nmailoa/ee149-proj/Presentation1.pptx

getCalibration

getAcceleration

getGyroscope

Serial.print(data)

## Slide 2

getCalibration

getAcceleration

getGyroscope

calibration?

Y

wait for button

populate cal.

Serial.write()

N

calibrated?

N

populate data

Y

reading > 4?

Y

N
