nmailoa/ee149-proj/final-report/figures/button.jpg

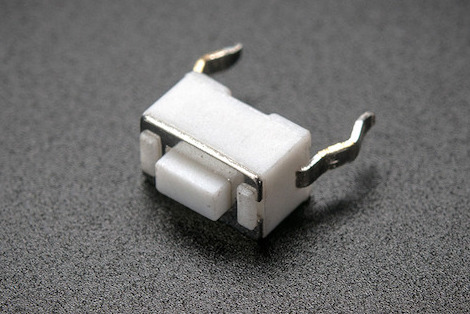
final-report/figures/button.jpg
