nmailoa/ee149-proj/final-report/figures/led.jpg

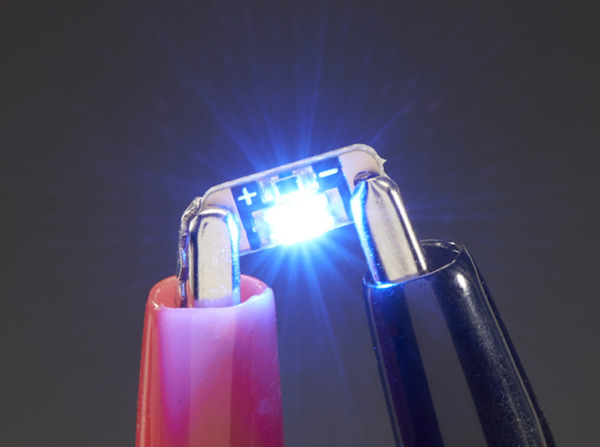
final-report/figures/led.jpg
