nmailoa/ee149-proj/full_body.png

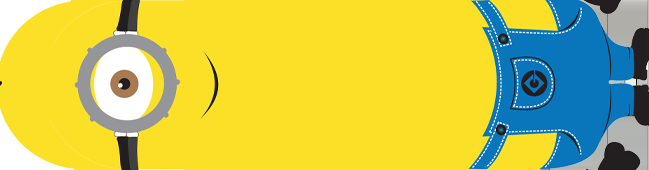
full_body.png
