nmailoa/ee149-proj/Screen Shot 2015-12-12 at 4.27.55 PM.png

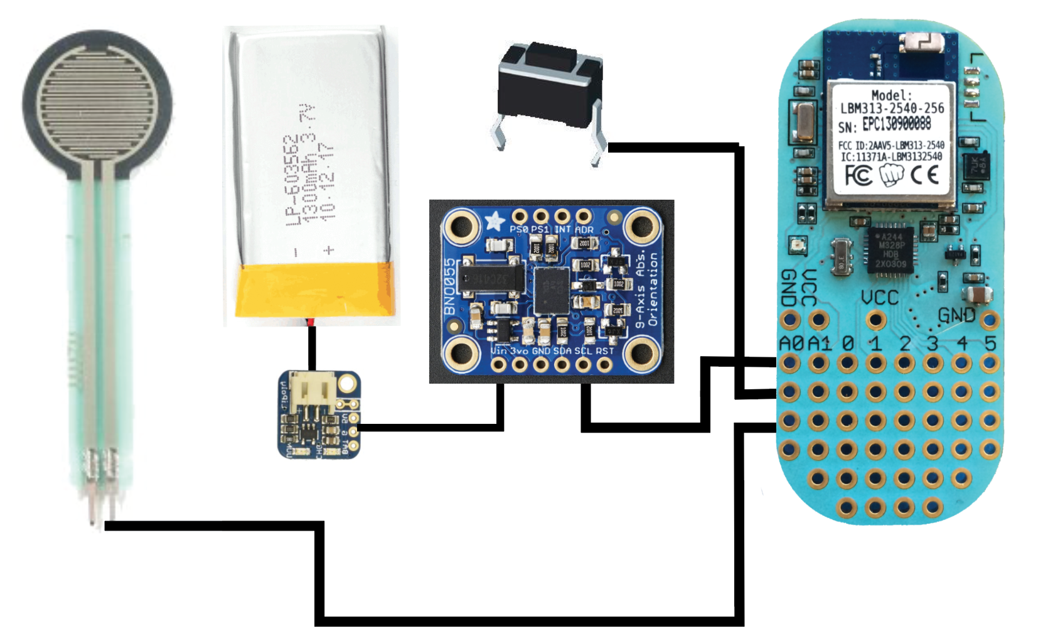
Screen Shot 2015-12-12 at 4.27.55 PM.png
