nmailoa/ee149-proj/arduino/speed/speed.ino

/* 
  This sketch reads the ambient temperature from the Bean's on-board temperature sensor. 
  
  The temperature readings are sent over serial and can be accessed in Arduino's Serial Monitor.
  
  To use the Serial Monitor, set Arduino's serial port to "/tmp/tty.LightBlue-Bean" 
  and the Bean as "Virtual Serial" in the OS X Bean Loader.
    
  This example code is in the public domain.
*/
char buf[100] = {0x30, 0x31, 0x32, 0x33, 0x34, 0x35, 0x36, 0x37, 0x38, 0x39,0x30, 0x31, 0x32, 0x33, 0x34, 0x35, 0x36, 0x37, 0x38, 0x39,0x30, 0x31, 0x32, 0x33, 0x34, 0x35, 0x36, 0x37, 0x38, 0x39,0x30, 0x31, 0x32, 0x33, 0x34, 0x35, 0x36, 0x37, 0x38, 0x39,0x30, 0x31, 0x32, 0x33, 0x34, 0x35, 0x36, 0x37, 0x38, 0x39,0x30, 0x31, 0x32, 0x33, 0x34, 0x35, 0x36, 0x37, 0x38, 0x39,0x30, 0x31, 0x32, 0x33, 0x34, 0x35, 0x36, 0x37, 0x38, 0x39,0x30, 0x31, 0x32, 0x33, 0x34, 0x35, 0x36, 0x37, 0x38, 0x39,0x30, 0x31, 0x32, 0x33, 0x34, 0x35, 0x36, 0x37, 0x38, 0x39,0x30, 0x31, 0x32, 0x33, 0x34, 0x35, 0x36, 0x37, 0x38, 0x39};

void setup() {
  // Bean Serial is at a fixed baud rate. Changing the value in Serial.begin() has no effect.
  Serial.begin(57600);
}

void loop() {
  // Get the current ambient temperature in degrees Celsius with a range of -40 C to 87 C.
  /*int temperature = Bean.getTemperature();
  
  Serial.print("Temperature: ");
  Serial.print(temperature);
  Serial.println(" C");
  Bean.sleep(3000);*/
  Serial.print(buf);
}
