nmailoa/ee149-proj/(commit log)

2015-10-19 add IMU option
2015-11-12 Includes Nathans modified ipython notebook and test_accel_data.
    [test_accel_data.csv]
2015-11-20 Added test circle csv data. this is calibrated.
    [test_circle.csv]
2015-11-20 updated accel_to_pos folder
    [sample.csv]
2015-11-20 added send calibration and fixed the register address
    [raw_accel.ino]
2015-11-20 print euler angles
2015-12-04 a bunch of new data
    [fastx.csv, fasty.csv, fastz.csv, stationary3.csv, stationary4.csv, stationary5.csv, x.csv, y.csv]
2015-12-05 moar data
    [spin.csv, x.csv, xy.csv, xz.csv, y.csv, yz.csv, z.csv]
2015-12-06 z step
    [z.csv]
2015-12-06 better circles, draw python
    [spin.csv, xz.csv, yz.csv]
2015-12-06 draw py
    [fastx.csv, fasty.csv, fastz.csv, line.csv, spin.csv]
2015-12-08 added position zeroing
    [xy.csv, zlong.csv]
2015-12-08 circle xy and stepflat works well
    [a.csv, a2.csv, circle-xy-flat.csv, stepflat.csv]
2015-12-10 live plotting
    [U.csv, temp.csv]
2015-12-12 added rxz filters hahahaha ha lulz nathan gets it
2015-12-17 LightBlueBean para
